Racketeer636/IDE_CPS26_Group_4/Mechanical/STLs/Bottom left frame.stl

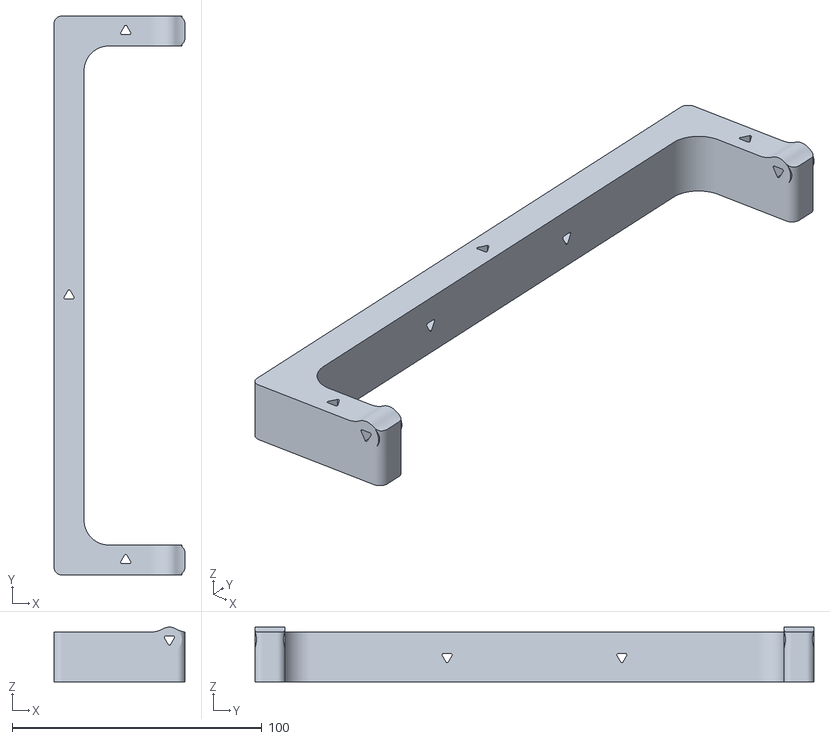
[picture p11: CAD file, 2026-11-12]
Mechanical/STLs/Bottom left frame.stl
52.4 x 224.0 x 22.0
