Racketeer636/IDE_CPS26_Group_4/Mechanical/STLs/Servo arm.stl

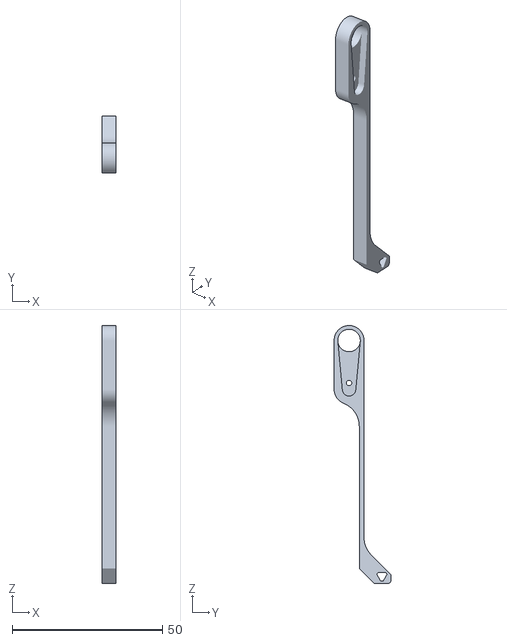
[picture p12: CAD file, 2026-11-12]
Mechanical/STLs/Servo arm.stl
4.65 x 18.9 x 86.0
