Racketeer636/IDE_CPS26_Group_4/Mechanical/STLs/Servo frame.stl

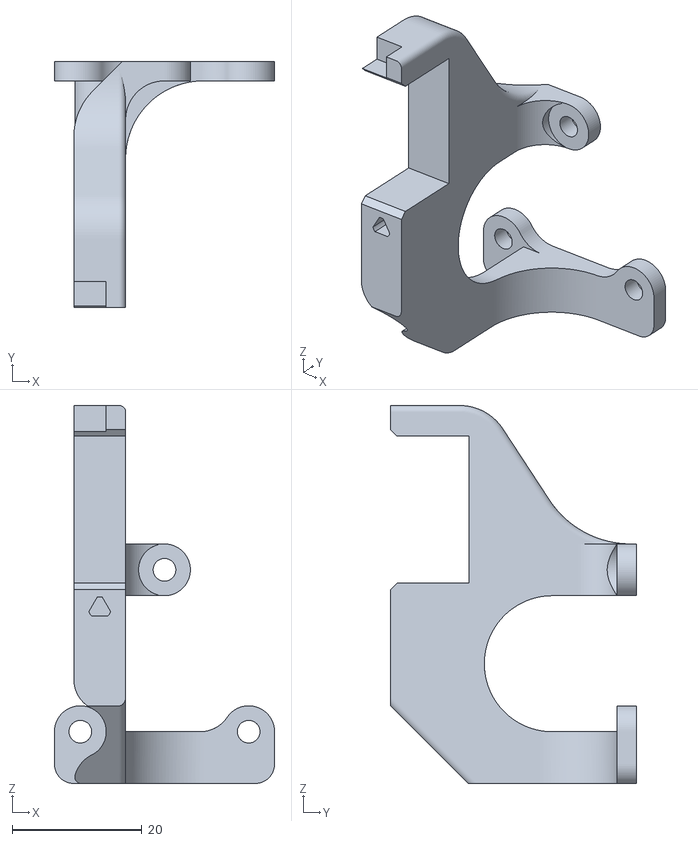
[picture p13: CAD file, 2026-11-12]
Mechanical/STLs/Servo frame.stl
34.0 x 38.0 x 58.4
