Racketeer636/IDE_CPS26_Group_4/Mechanical/STLs/Tuner frame - top.stl

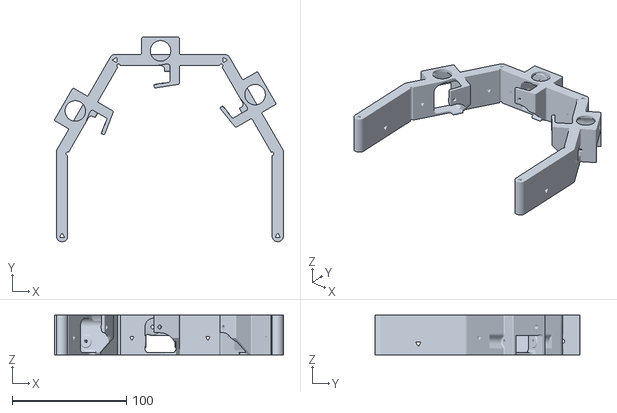
[picture p14: CAD file, 2026-11-12]
Mechanical/STLs/Tuner frame - top.stl
200.8 x 179.4 x 35.0
