Racketeer636/IDE_CPS26_Group_4/Mechanical/STLs/Tuner Worm.stl

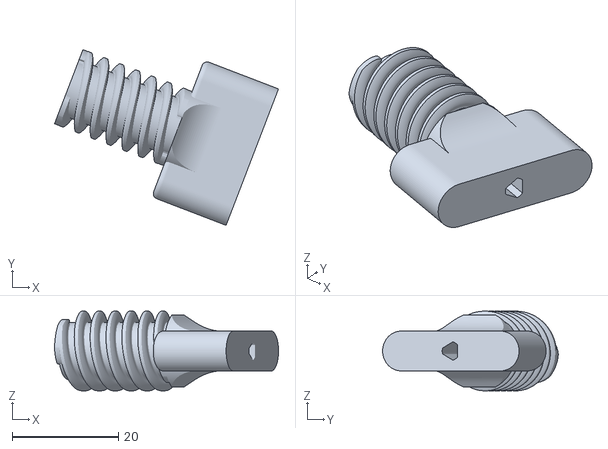
[picture p15: CAD file, 2026-11-12]
Mechanical/STLs/Tuner Worm.stl
42.1 x 33.1 x 15.0
