Racketeer636/IDE_CPS26_Group_4/Mechanical/STLs/Strummer bottom wheel.stl

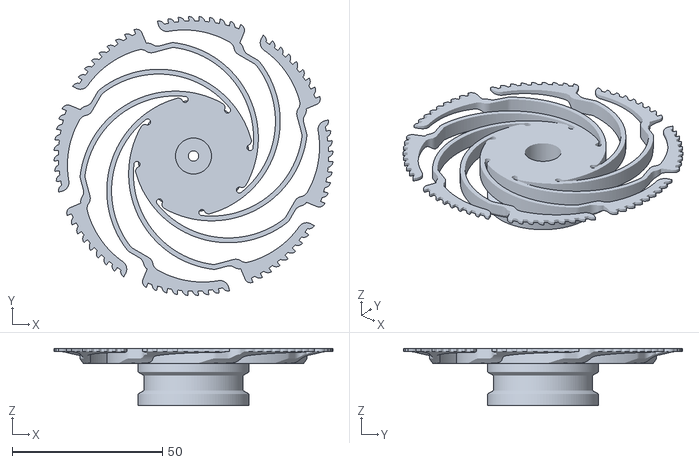
[picture p16: CAD file, 2026-11-12]
Mechanical/STLs/Strummer bottom wheel.stl
93.0 x 93.0 x 19.0
