Racketeer636/IDE_CPS26_Group_4/Mechanical/STLs/Bridge.stl

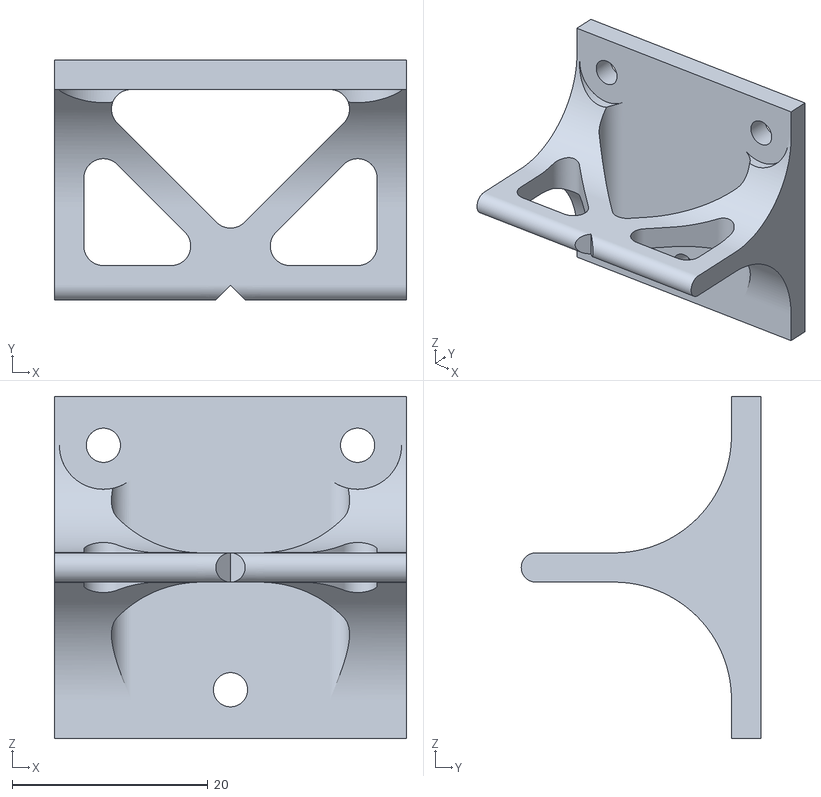
[picture p17: CAD file, 2026-11-12]
Mechanical/STLs/Bridge.stl
36.0 x 24.5 x 35.0
