Racketeer636/IDE_CPS26_Group_4/Mechanical/STLs/Strummer DC motor cap.stl

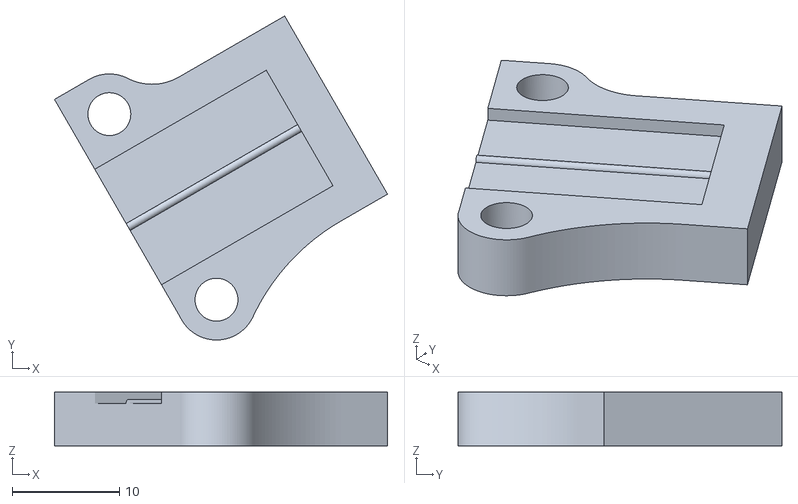
[picture p18: CAD file, 2026-11-12]
Mechanical/STLs/Strummer DC motor cap.stl
31.1 x 30.2 x 5.00
