Racketeer636/IDE_CPS26_Group_4/Mechanical/STLs/Strummer pulley.stl

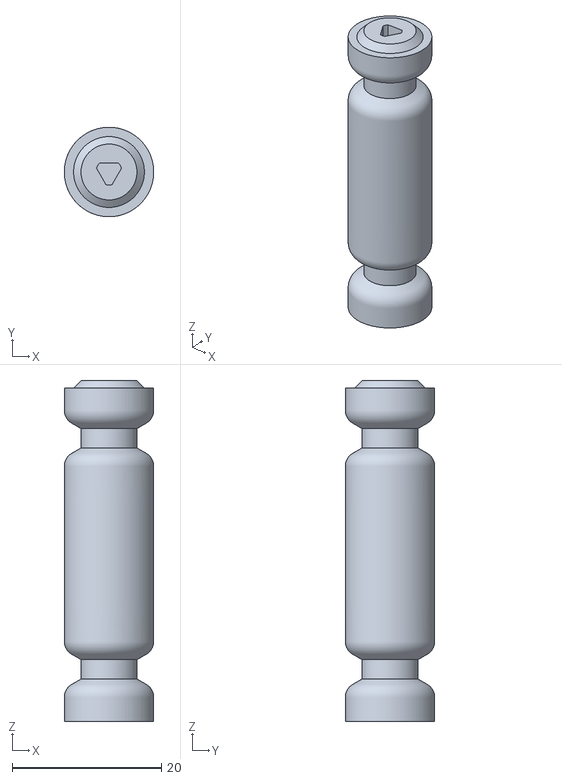
[picture p19: CAD file, 2026-11-12]
Mechanical/STLs/Strummer pulley.stl
12.0 x 12.0 x 45.8
