Racketeer636/IDE_CPS26_Group_4/Mechanical/STLs/Strummer midframe.stl

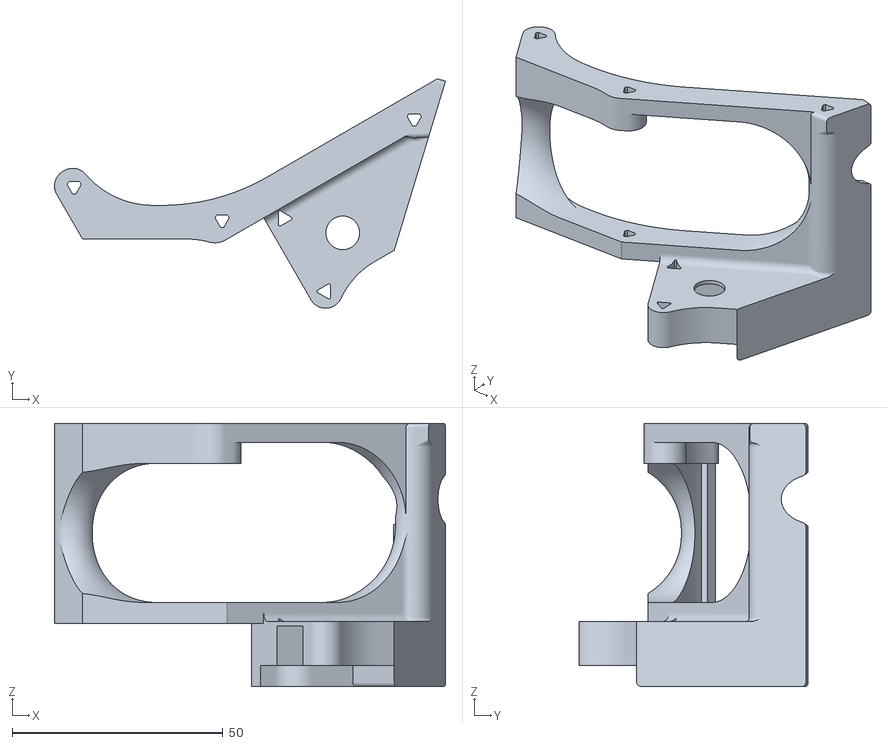
[picture p20: CAD file, 2026-11-12]
Mechanical/STLs/Strummer midframe.stl
92.9 x 54.5 x 62.5
