Racketeer636/IDE_CPS26_Group_4/Mechanical/STLs/Strummer bottom frame.stl

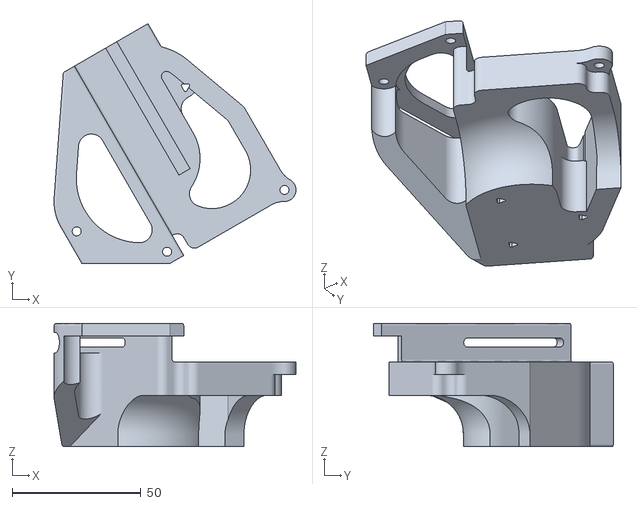
[picture p21: CAD file, 2026-11-12]
Mechanical/STLs/Strummer bottom frame.stl
94.1 x 93.2 x 48.0
