Racketeer636/IDE_CPS26_Group_4/Mechanical/STLs/Servo cap.stl

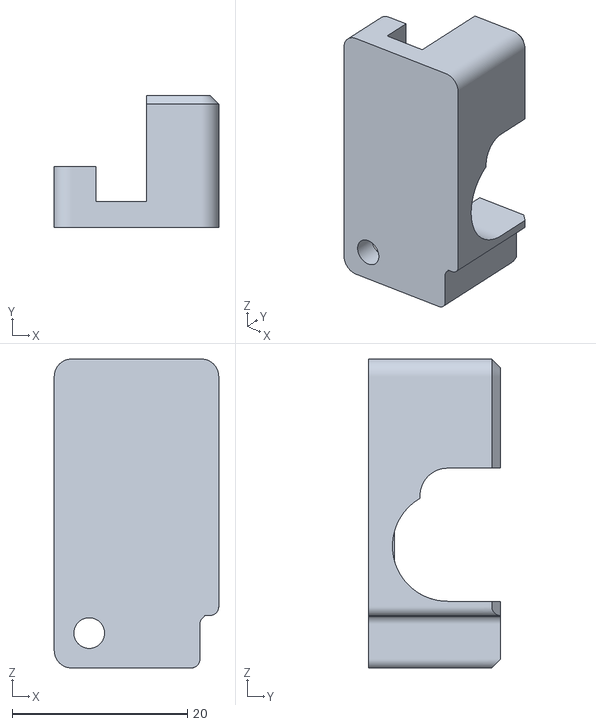
[picture p22: CAD file, 2026-11-12]
Mechanical/STLs/Servo cap.stl
18.8 x 15.1 x 35.3
