Racketeer636/IDE_CPS26_Group_4/Mechanical/STLs/Strummer upper frame.stl

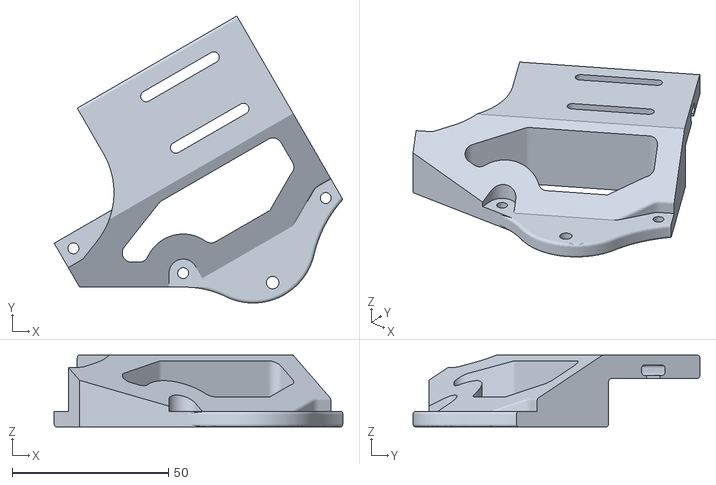
[picture p23: CAD file, 2026-11-12]
Mechanical/STLs/Strummer upper frame.stl
92.4 x 91.9 x 23.0
