Racketeer636/IDE_CPS26_Group_4/Mechanical/STLs/Tuner gear.stl

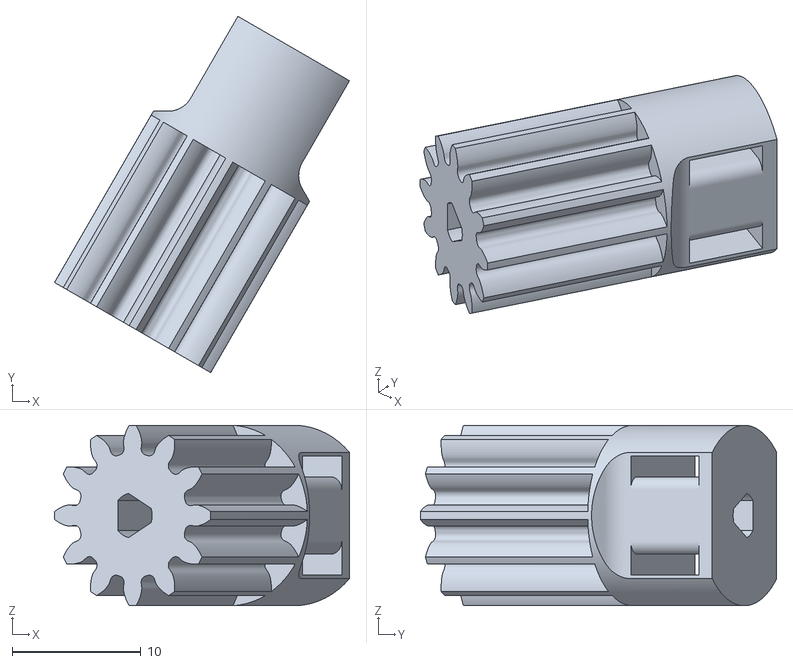
[picture p24: CAD file, 2026-11-12]
Mechanical/STLs/Tuner gear.stl
22.9 x 27.7 x 14.0
