Racketeer636/IDE_CPS26_Group_4/Mechanical/STLs/Strummer top slide.stl

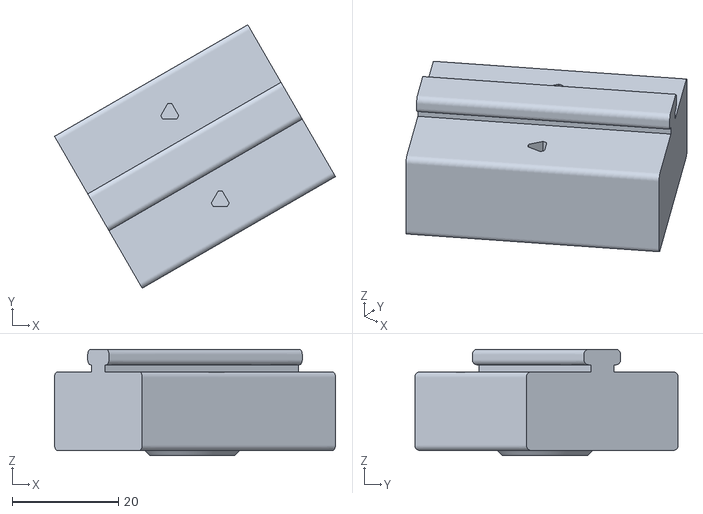
[picture p25: CAD file, 2026-11-12]
Mechanical/STLs/Strummer top slide.stl
52.9 x 49.6 x 20.0
