Racketeer636/IDE_CPS26_Group_4/Mechanical/STLs/Backboard mount.stl

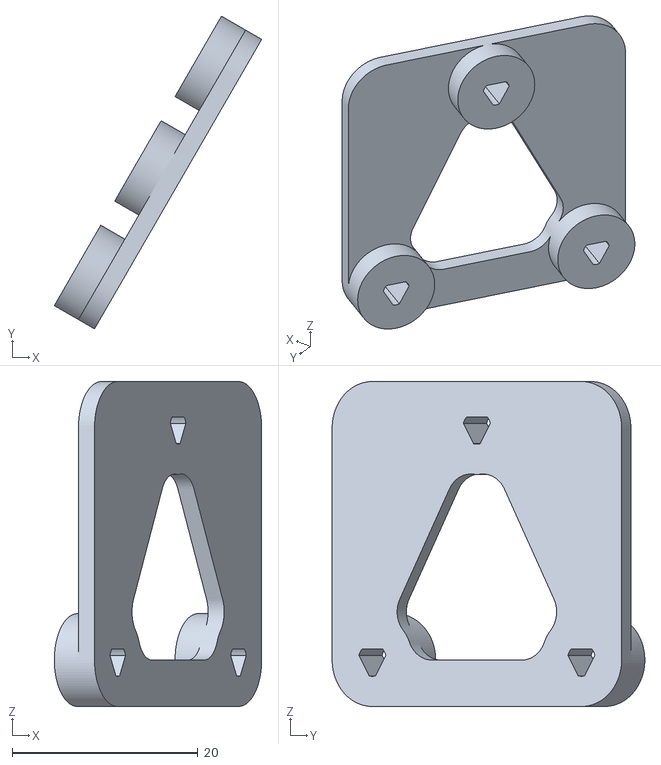
[picture p26: CAD file, 2026-11-12]
Mechanical/STLs/Backboard mount.stl
22.3 x 33.7 x 35.0
