Racketeer636/IDE_CPS26_Group_4/Mechanical/STLs/Strummer bottom slide.stl

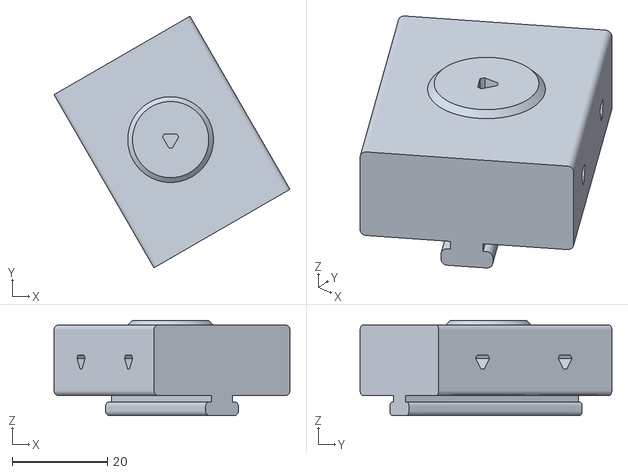
[picture p27: CAD file, 2026-11-12]
Mechanical/STLs/Strummer bottom slide.stl
49.6 x 52.9 x 20.0
