Racketeer636/IDE_CPS26_Group_4/(list of files, cad)

Other CAD files:
Mechanical/STLs/Top left frame.stl
Mechanical/STLs/Strummer top wheel.stl
Mechanical/STLs/Bottom right frame.stl
Mechanical/STLs/Top right frame.stl
